dave18/ppa-pcmcia-sram/board/v2.1+/SRAM 4MB_2.1+.brd

## EAGLE design board/v2.1+/SRAM 4MB_2.1+.brd (2023-03-23)

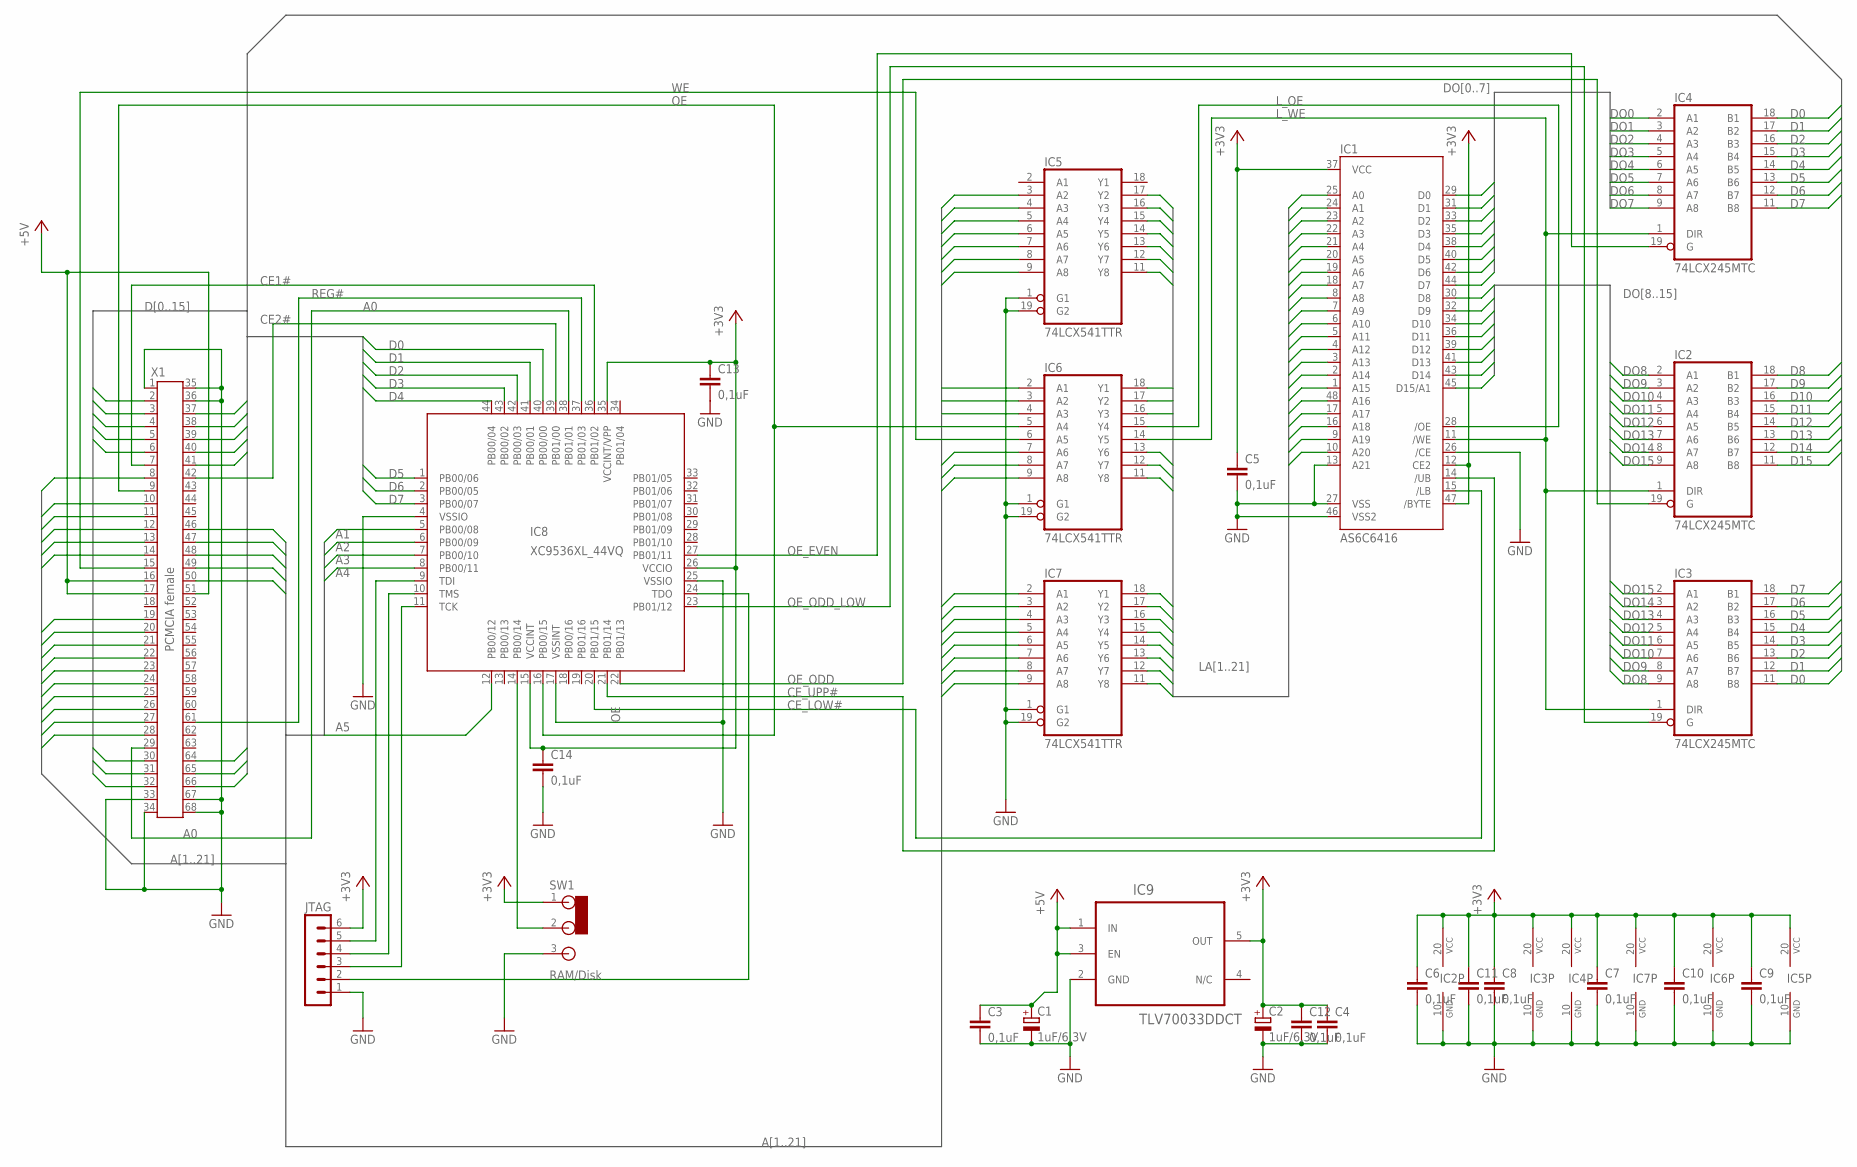
[picture p1: schematic SRAM 4MB_2.1+.sch]

Parts:
C1, C2: 1uF/6,3V; A/3216-18R
C3, C4: 0,1uF; C0603
C5, C6, C7, C8, C9, C10, C11, C12, C13, C14: 0,1uF; C0402K
IC1: AS6C6416; TSOP48
IC2, IC3, IC4: 74LCX245MTC; TSSOP20
IC5, IC6, IC7: 74LCX541TTR; TSSOP20
IC8: XC9536XL_44VQ; SQFP-S-10X10-44
IC9: TLV70033DDCT; SOT95P280X110-5N
JTAG: MA06-1
SW1: RAM/Disk; SWITCH2
X1: PCMCIA female; 9M681X04

Connections:
+3V3: C2.+, C4.1, C5.1, C6.1, C7.1, C8.1, C9.1, C10.1, C11.1, C12.1, C13.1, C14.1, IC1.12 (CE2), IC1.37 (VCC), IC1.47 (/BYTE), IC2.20 (VCC), IC3.20 (VCC), IC4.20 (VCC), IC5.20 (VCC), IC6.20 (VCC), IC7.20 (VCC), IC8.15 (VCCINT), IC8.26 (VCCIO), IC8.35 (VCCINT/VPP), IC9.5 (OUT), JTAG.6, SW1.1
+5V: C1.+, C3.1, IC9.1 (IN), IC9.3 (EN), X1.16, X1.17, X1.51
A0: IC8.38 (PB01/01), X1.29
A1: IC5.3 (A2), IC8.5 (PB00/08), X1.28
A2: IC5.4 (A3), IC8.6 (PB00/09), X1.27
A3: IC5.5 (A4), IC8.7 (PB00/10), X1.26
A4: IC5.6 (A5), IC8.8 (PB00/11), X1.25
A5: IC5.7 (A6), IC8.12 (PB00/12), X1.24
A6: IC5.8 (A7), X1.23
A7: IC5.9 (A8), X1.22
A8: IC7.6 (A5), X1.12
A9: IC7.7 (A6), X1.11
A10: IC7.9 (A8), X1.8
A11: IC7.8 (A7), X1.10
A12: IC6.2 (A1), X1.21
A13: IC7.4 (A3), X1.13
A14: IC7.2 (A1), X1.14
A15: IC6.3 (A2), X1.20
A16: IC6.4 (A3), X1.19
A17: IC7.5 (A4), X1.46
A18: IC7.3 (A2), X1.47
A19: IC6.9 (A8), X1.48
A20: IC6.8 (A7), X1.49
A21: IC6.7 (A6), X1.50
CE1#: IC8.36 (PB01/02), X1.7
CE2#: IC8.39 (PB01/00), X1.42
CE_LOW#: IC1.15 (/LB), IC8.20 (PB01/15)
CE_UPP#: IC1.14 (/UB), IC8.21 (PB01/14)
D0: IC3.11 (B8), IC4.18 (B1), IC8.40 (PB00/00), X1.30
D1: IC3.12 (B7), IC4.17 (B2), IC8.41 (PB00/01), X1.31
D2: IC3.13 (B6), IC4.16 (B3), IC8.42 (PB00/03), X1.32
D3: IC3.14 (B5), IC4.15 (B4), IC8.43 (PB00/02), X1.2
D4: IC3.15 (B4), IC4.14 (B5), IC8.44 (PB00/04), X1.3
D5: IC3.16 (B3), IC4.13 (B6), IC8.1 (PB00/06), X1.4
D6: IC3.17 (B2), IC4.12 (B7), IC8.2 (PB00/05), X1.5
D7: IC3.18 (B1), IC4.11 (B8), IC8.3 (PB00/07), X1.6
D8: IC2.18 (B1), X1.64
D9: IC2.17 (B2), X1.65
D10: IC2.16 (B3), X1.66
D11: IC2.15 (B4), X1.37
D12: IC2.14 (B5), X1.38
D13: IC2.13 (B6), X1.39
D14: IC2.12 (B7), X1.40
D15: IC2.11 (B8), X1.41
DO0: IC1.29 (D0), IC4.2 (A1)
DO1: IC1.31 (D1), IC4.3 (A2)
DO2: IC1.33 (D2), IC4.4 (A3)
DO3: IC1.35 (D3), IC4.5 (A4)
DO4: IC1.38 (D4), IC4.6 (A5)
DO5: IC1.40 (D5), IC4.7 (A6)
DO6: IC1.42 (D6), IC4.8 (A7)
DO7: IC1.44 (D7), IC4.9 (A8)
DO8: IC1.30 (D8), IC2.2 (A1), IC3.9 (A8)
DO9: IC1.32 (D9), IC2.3 (A2), IC3.8 (A7)
DO10: IC1.34 (D10), IC2.4 (A3), IC3.7 (A6)
DO11: IC1.36 (D11), IC2.5 (A4), IC3.6 (A5)
DO12: IC1.39 (D12), IC2.6 (A5), IC3.5 (A4)
DO13: IC1.41 (D13), IC2.7 (A6), IC3.4 (A3)
DO14: IC1.43 (D14), IC2.8 (A7), IC3.3 (A2)
DO15: IC1.45 (D15/A1), IC2.9 (A8), IC3.2 (A1)
GND: C1.-, C2.-, C3.2, C4.2, C5.2, C6.2, C7.2, C8.2, C9.2, C10.2, C11.2, C12.2, C13.2, C14.2, IC1.13 (A21), IC1.26 (/CE), IC1.27 (VSS), IC1.46 (VSS2), IC2.10 (GND), IC3.10 (GND), IC4.10 (GND), IC5.1 (G1), IC5.10 (GND), IC5.19 (G2), IC6.1 (G1), IC6.10 (GND), IC6.19 (G2), IC7.1 (G1), IC7.10 (GND), IC7.19 (G2), IC8.4 (VSSIO), IC8.17 (VSSINT), IC8.25 (VSSIO), IC9.2 (GND), JTAG.1, SW1.3, X1.1, X1.33, X1.34, X1.35, X1.36, X1.67, X1.68
LA1: IC1.25 (A0), IC6.16 (Y3)
LA2: IC1.24 (A1), IC5.17 (Y2)
LA3: IC1.23 (A2), IC5.16 (Y3)
LA4: IC1.22 (A3), IC5.15 (Y4)
LA5: IC1.21 (A4), IC5.14 (Y5)
LA6: IC1.20 (A5), IC5.13 (Y6)
LA7: IC1.19 (A6), IC5.12 (Y7)
LA8: IC1.18 (A7), IC5.11 (Y8)
LA9: IC1.8 (A8), IC6.11 (Y8)
LA10: IC1.7 (A9), IC7.11 (Y8)
LA11: IC1.6 (A10), IC7.12 (Y7)
LA12: IC1.5 (A11), IC7.13 (Y6)
LA13: IC1.4 (A12), IC7.14 (Y5)
LA14: IC1.3 (A13), IC7.15 (Y4)
LA15: IC1.2 (A14), IC7.16 (Y3)
LA16: IC1.1 (A15), IC7.17 (Y2)
LA17: IC1.48 (A16), IC7.18 (Y1)
LA18: IC1.17 (A17), IC6.18 (Y1)
LA19: IC1.16 (A18), IC6.17 (Y2)
LA20: IC1.9 (A19), IC6.12 (Y7)
LA21: IC1.10 (A20), IC6.13 (Y6)
L_OE: IC1.28 (/OE), IC6.15 (Y4)
L_WE: IC1.11 (/WE), IC2.1 (DIR), IC3.1 (DIR), IC4.1 (DIR), IC6.14 (Y5)
unnamed: IC8.24 (TDO), JTAG.2
unnamed: IC8.11 (TCK), JTAG.3
unnamed: IC8.10 (TMS), JTAG.4
unnamed: IC8.9 (TDI), JTAG.5
unnamed: IC8.14 (PB00/14), SW1.2
OE: IC6.5 (A4), IC8.16 (PB00/15), X1.9
OE_EVEN: IC4.19 (G), IC8.27 (PB01/11)
OE_ODD: IC2.19 (G), IC8.22 (PB01/13)
OE_ODD_LOW: IC3.19 (G), IC8.23 (PB01/12)
REG#: IC8.37 (PB01/03), X1.61
WE: IC6.6 (A5), X1.15

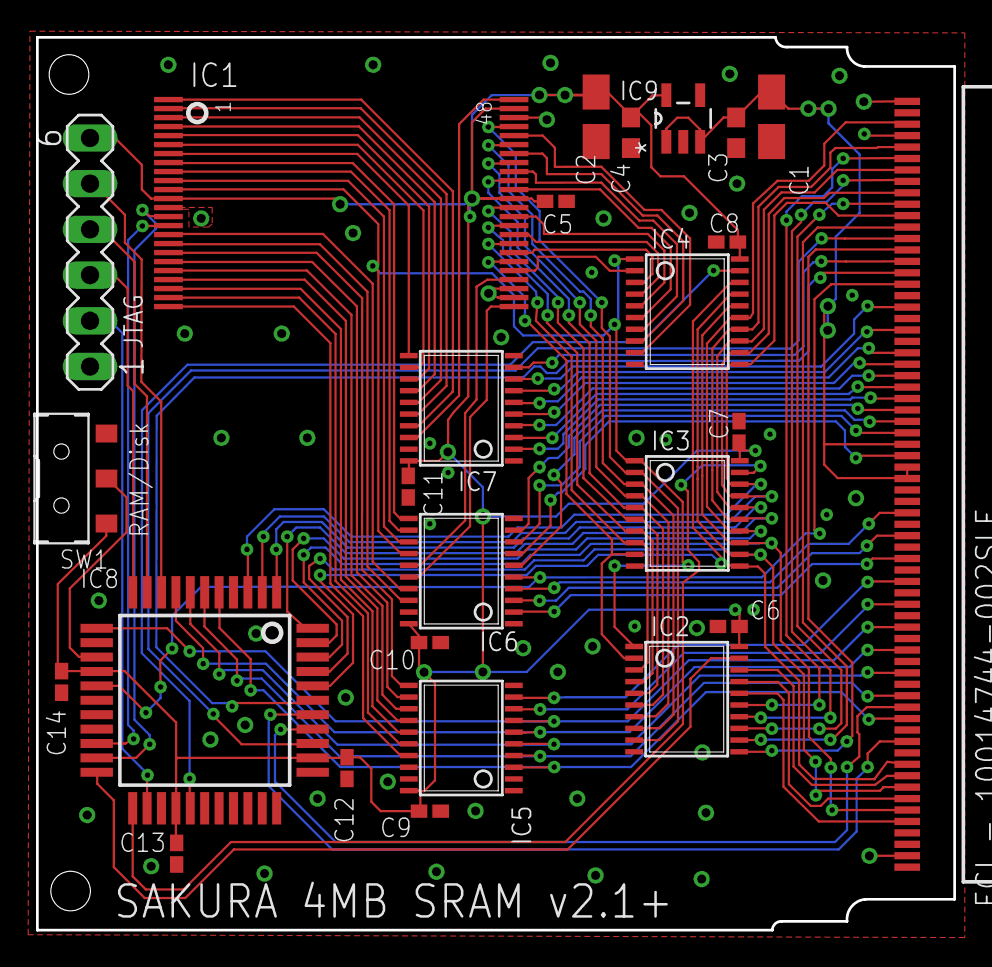
[picture p2: board SRAM 4MB_2.1+.brd from above]

Board: 2 copper layers, 51.0 x 49.6 mm, 26 parts (0 on the bottom side), 95 nets.
